junits15/FreeLoad/board render capture.PNG

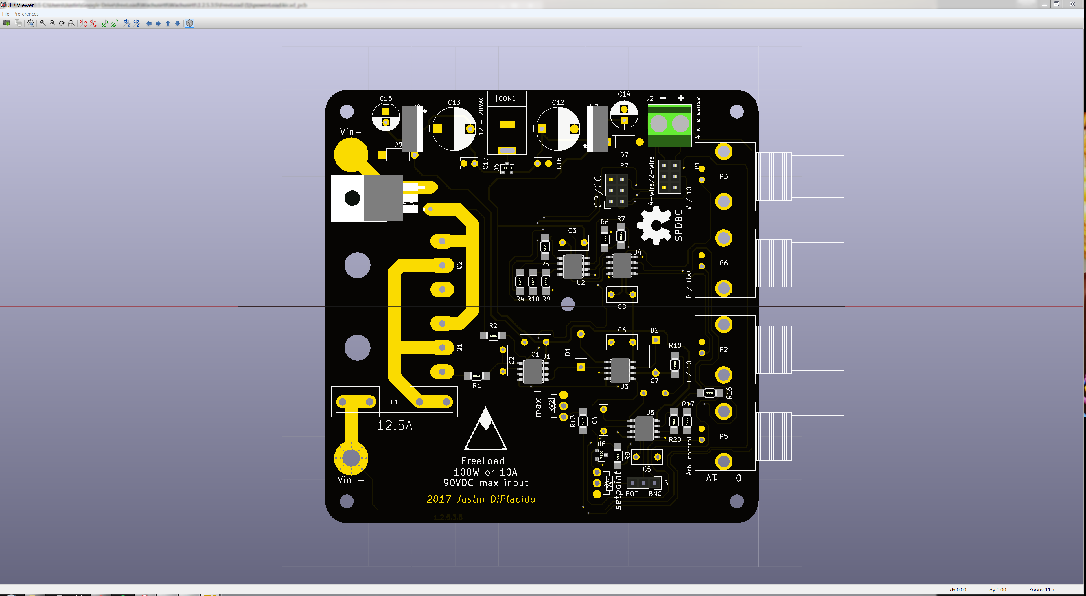
board render capture.PNG
