junits15/FreeLoad/Schematic.pdf

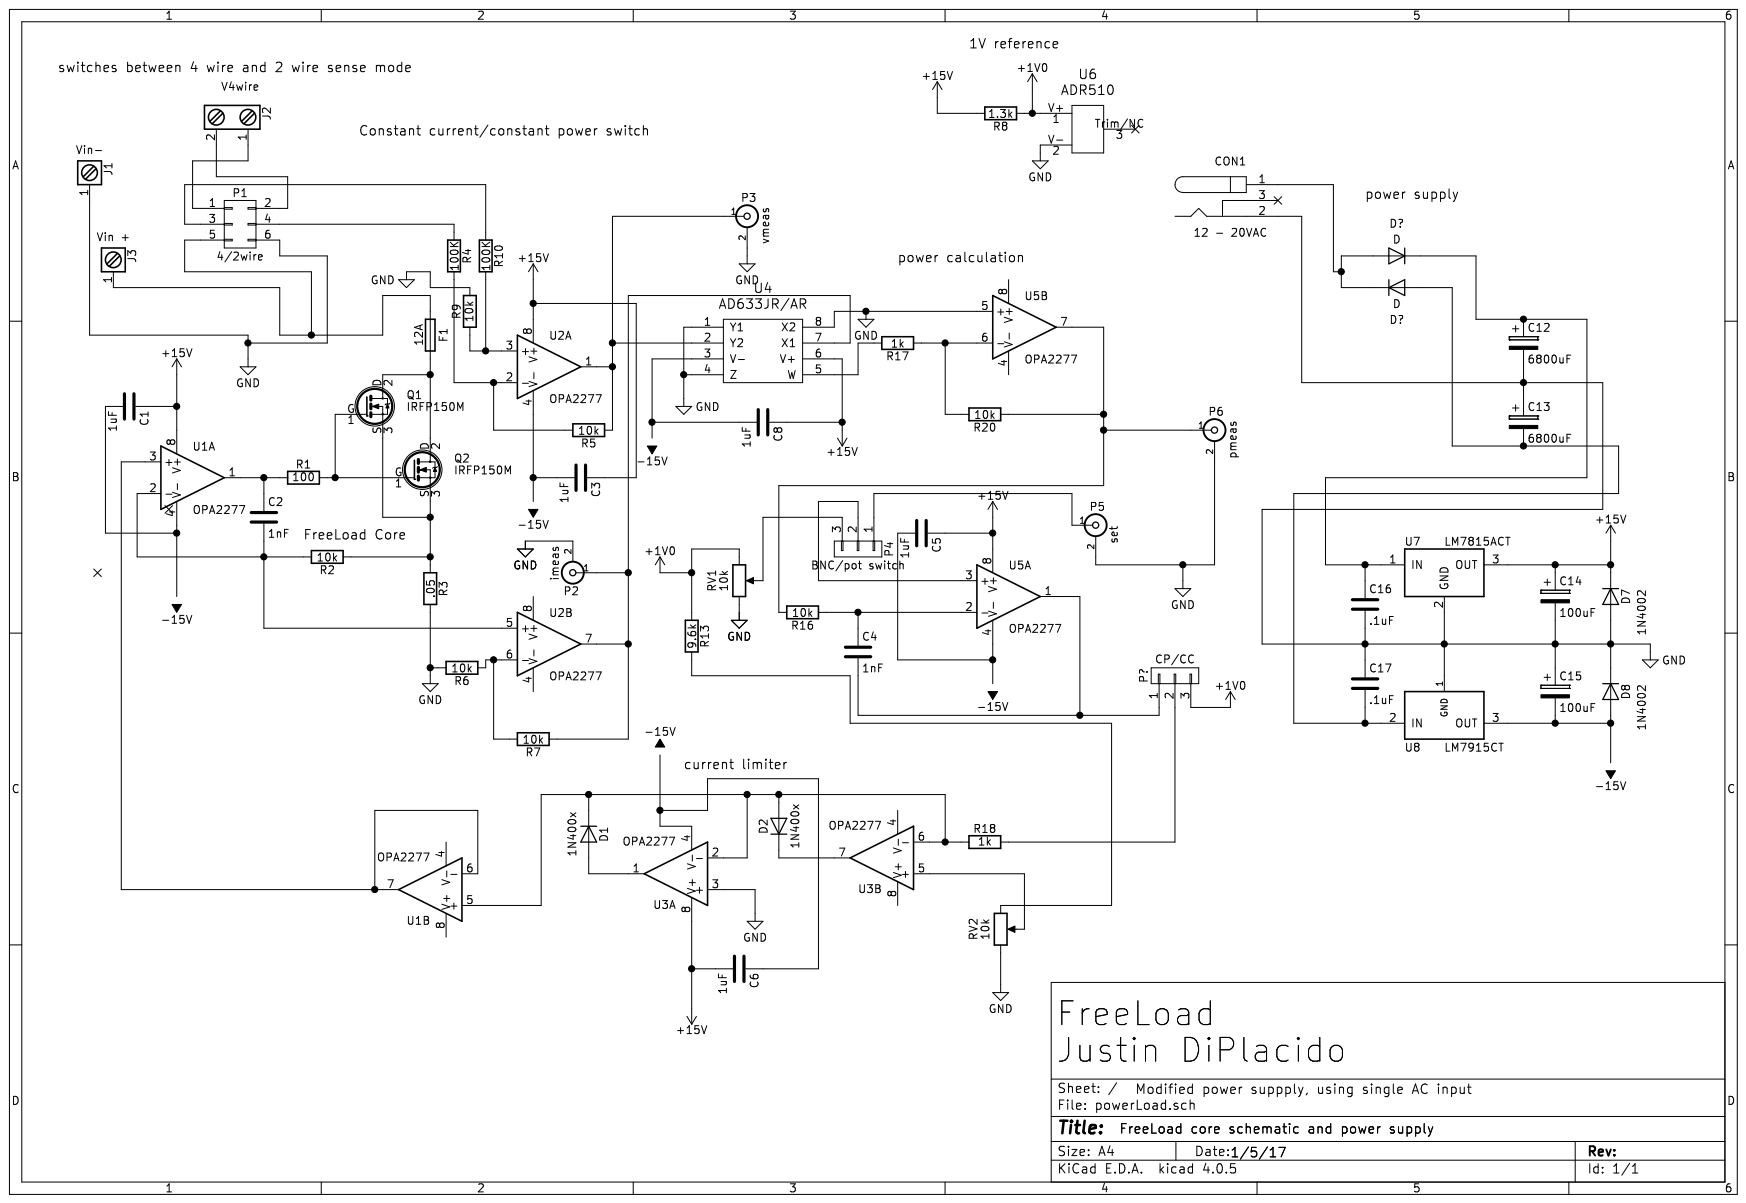
[picture p2: page 1]
