junits15/FreeLoad/(list of files, drawings)

Other design files:
Freeload.ms14
