junits15/FreeLoad/(commit log)

2016-11-21 Initital Simulation
    CI CP simulation file
    [Freeload.ms14]
2016-11-21 Core schematic
    core FreeLoad schematic
2016-11-22 Updated the way the 633 is connected
    Swapped the connections for the voltage measurement.
2016-12-30 switching to plaintext
2017-01-03 Schematic and board design
    Contains the v1.2 schematic, board layout v1.0 and gerber files.
2017-01-03 Schematic v1.2
    Second revision of core schematic, featuring two feedback loops and compensation for oscillations. This schematic went into fabrication round 1.
2017-01-03 First schematic revision - preproduction
    First schematic, without dual control loops. Featured split switchable control loop that proved to be very difficult to compensate. Oscillations were extremely large and caused a lot of error in measurements. This schematic was NOT sent to fabrication, no board was created.
2017-01-03 changing branches
    [Freeload.ms14]
2017-01-03 Previous design files and simulations
    Contains the first revision of the design, with a single switchable control loop. This design proved to be very difficult to compensate and filter. Large oscillations caused significant error in measurements. Also contains NI Multisim file.
    [Freeload.ms14]
2017-01-03 New schematic and board layout
    Contain revised dual control loop schematic, oscillations fixed. Board has been laid out and sent to SeedStudio.
2017-01-03 3D render of PCB v1.2
    3D rendition of the PCB, some components not rendered.
2017-01-04 added changes for next board and schematic
2017-01-04 Most current design
    this is the most current design, board is ini production. Awaiting delivery from board house.
2017-01-12 added observations for first prototype
    observations and changed for first prototype, first prototype appears to be working.
2017-01-12 changed featureset 2
    removed "single rail operation" as this is not yet possible, also removed "consider better fuse options" because a standard 5x20 fuse is good enough.
    Added "+/- 15V rails", "4 wire sense" and "half wave rectification"
2017-01-25 updating to more current board
    updating to next layout
2017-03-22 Latest Schematic
2017-03-22 new board render
